stefangrozdanovski-sys/modular_esp32_board/hardware/docs/board_bottom.png

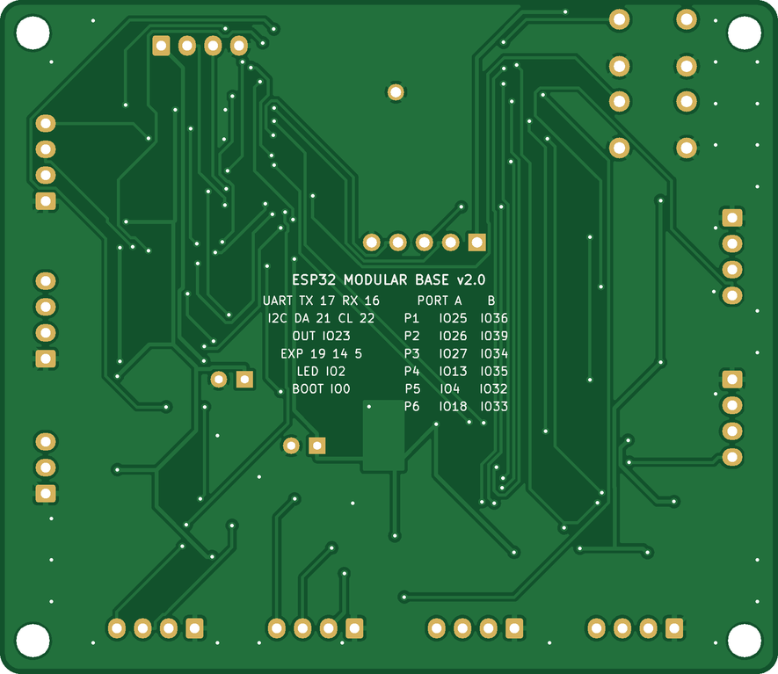
hardware/docs/board_bottom.png
