stefangrozdanovski-sys/modular_esp32_board/production/pcba/esp32-modular-v2.0-BOM-JLCPCB.csv

Comment | Designator | Footprint | LCSC Part #
ESP32-WROOM-32E-N4 | U1 | ESP32-WROOM-32_HandSolder | C701341
AMS1117-3.3 | U2 | SOT-223-3_TabPin2 | C6186
CH340C | U3 | SOIC-16_3.9x9.9mm_P1.27mm | C84681
USBLC6-2SC6 | U4 | SOT-23-6 | C7519
MMBT3904 | Q1,Q2 | SOT-23 | C20526
AO3400A | Q901 | SOT-23 | C20917
SMAJ5.0A | D1 | D_SMA_Handsoldering | C113952
SS34 | D901 | D_SMA_Handsoldering | C8678
PTC 1.1A 1812 | F1 | Fuse_1812_4532Metric_Pad1.30x3.40mm_HandSolder | C163516
PTC 0.5A 1206 | F101,F201,F301,F401,F501,F601,F701,F801 | Fuse_1206_3216Metric_Pad1.42x1.75mm_HandSolder | C883122
22uF 0805 | C3 | C_0805_2012Metric_Pad1.18x1.45mm_HandSolder | C45783
10uF 0805 | C2,C6 | C_0805_2012Metric_Pad1.18x1.45mm_HandSolder | C15850
1uF 0805 | C7 | C_0805_2012Metric_Pad1.18x1.45mm_HandSolder | C28323
100nF 0805 | C5,C8 | C_0805_2012Metric_Pad1.18x1.45mm_HandSolder | C49678
330R 0805 | R101,R201,R301,R401,R501,R601,R701 | R_0805_2012Metric_Pad1.20x1.40mm_HandSolder | C17630
1k 0805 | R10,R11,R104,R204,R304,R404,R504,R604 | R_0805_2012Metric_Pad1.20x1.40mm_HandSolder | C17513
10k 0805 | R1,R2,R3,R4,R704 | R_0805_2012Metric_Pad1.20x1.40mm_HandSolder | C17414
100R 0805 | R801,R804,R901 | R_0805_2012Metric_Pad1.20x1.40mm_HandSolder | C17408
470R 0805 | R5 | R_0805_2012Metric_Pad1.20x1.40mm_HandSolder | C17710
4.7k 0805 | R802,R805 | R_0805_2012Metric_Pad1.20x1.40mm_HandSolder | C17673
22k 0805 | R706 | R_0805_2012Metric_Pad1.20x1.40mm_HandSolder | C17560
100k 0805 | R902 | R_0805_2012Metric_Pad1.20x1.40mm_HandSolder | C149504
LED red 0805 | LED1 | LED_0805_2012Metric_Pad1.15x1.40mm_HandSolder | C84256
LED yellow 0805 | LED2 | LED_0805_2012Metric_Pad1.15x1.40mm_HandSolder | C2296
