stefangrozdanovski-sys/modular_esp32_board/hardware/bom/esp32-modular-v2.0-BOM.xlsx

Sheet: Read me
ESP32 Modular Base v2.0: bill of materials
Schematic and PCB done 2026-10-13 (75 x 65 mm, 2 layers). Generated from the same parts list as the schematic.
 | Build settings
 | Boards to build | 5 | All "Need" quantities scale with this number.
 | How to use this file
 | Yellow cell, blue text |  | You fill this in: In stock, Unit price, Boards to build, option quantities, Fit status.
 | White cell, black text |  | Calculated. Do not type over it.
 | Red-tinted row |  | Something still has to be bought (To buy > 0).
 | Need |  | Qty per board x Boards to build + Spares. Spares cover 0805 parts that fly off the tweezers.
 | To buy |  | Need minus In stock, never below zero.
 | Where to look first |  | My estimate of which parts a local electronics store usually carries. Not a stock check.
 | Qty per board |  | Counted from the Per reference sheet. Change a Fit status there (e.g. DNP to Fit) and the BOM follows.
 | Example row |  | BOM line "XH 3P socket" shows the format: In stock = 100 (the 3P stock you mentioned).
 | Totals
 | Parts per board (placed) | 68
 | BOM lines still to buy | 47
 | Cost of parts to buy (€) | €0.00
 | Note | Cost counts only lines where you entered a unit price.
 | Sheets
 | BOM |  | Every part on the PCB, grouped by value. Stock, to-buy and cost columns.
 | Port options |  | Port map, what each option footprint is for, setup recipes, and option parts to keep in the drawer.
 | Off-board |  | Mating connectors, cables, standoffs, PCB order, crimp tool.
 | Per reference |  | One row per reference designator: value, fitted or empty, footprint. Use it while soldering.

Sheet: BOM
BOM: parts on the PCB
Qty per board and empty footprints are counted from the Per reference sheet. Fill the yellow cells.
# | Block | References | Value | Package | What to look for | Qty / board | Empty footprints | Spares | Need | In stock | To buy | Where to look first | AliExpress search | Substitutes | Typical pack | Unit price (€) | Line cost (€) | Notes
1 | MCU | U1 | ESP-32S (Ai-Thinker) | WROOM-32 footprint, 38 castellated pads | 4 MB flash. WROOM-32 / WROOM-32E fit the same pads | 1 | 0 | 0 | 5 |  | 5 | Have | Ai-Thinker ESP-32S module | ESP32-WROOM-32E (N4), ESP32-WROOM-32D | 1 |  | €0.00 | You already have these: enter the count in "In stock".
2 | 3V3 rail | U2 | AMS1117-3.3 | SOT-223 | 3.3 V fixed LDO, 1 A, tab = output | 1 | 0 | 1 | 6 |  | 6 | Local likely | AMS1117-3.3 SOT-223 | LD1117S33 (same pinout) | 10-50 |  | €0.00 | Not the ADJ version.
3 | USB-UART | U3 | CH340C | SOIC-16 | Must be the C variant: internal oscillator, no crystal | 1 | 0 | 1 | 6 |  | 6 | AliExpress | CH340C SOP-16 | None on this footprint (CH340G needs a crystal) | 10 |  | €0.00 | Marking "CH340C".
4 | USB-UART | U4 | USBLC6-2SC6 | SOT-23-6 | USB ESD protection, 2 lines | 1 | 0 | 1 | 6 |  | 6 | AliExpress | USBLC6-2SC6 SOT-23-6 | USBLC6-2SC6Y | 10-20 |  | €0.00 | If you cannot get it, leave U4 empty: the board works, just without USB ESD protection.
5 | USB-UART | Q1 Q2 | MMBT3904 | SOT-23 | NPN, pin 1 B, 2 E, 3 C (marking 1AM) | 2 | 0 | 1 | 11 |  | 11 | Local maybe | MMBT3904 SOT-23 | MMBT2222A (1P), S8050 SOT-23 (J3Y): same pinout | 50-100 |  | €0.00 | Auto-reset pair.
6 | OUT | Q901 | AO3400A | SOT-23 | N-MOSFET 30 V 5.7 A, logic level (works from 3.3 V gate) | 1 | 0 | 1 | 6 |  | 6 | AliExpress | AO3400A SOT-23 | SI2302 (A2SHB): 20 V max, so 12 V loads only | 50-100 |  | €0.00 | Marking "A09T".
7 | Power in | D1 | SMAJ5.0A | SMA (DO-214AC) | Unidirectional TVS, 5.0 V standoff | 1 | 0 | 1 | 6 |  | 6 | Local maybe | SMAJ5.0A SMA | SMAJ5.0A from any maker. Not the "CA" (bidirectional) | 20-100 |  | €0.00 | Band (cathode) toward +5V.
8 | OUT | D901 | SS34 | SMA (DO-214AC) | Schottky 40 V 3 A | 1 | 0 | 1 | 6 |  | 6 | Local maybe | SS34 SMA DO-214AC | SS24, SS36, SS14 (1 A, fine for small loads) | 50-100 |  | €0.00 | Check the package is SMA, not SMB. Band toward V+.
9 | Power in | F1 | PTC 1.1 A hold | 1812 | Resettable fuse, 1.1 A hold, >= 6 V | 1 | 0 | 1 | 6 |  | 6 | Local maybe | 1812 PTC 1.1A SMD resettable fuse | Bourns MF-MSMF110-2, Littelfuse 1812L110 | 10-50 |  | €0.00 | Marking often "110".
10 | Ports | F101 F201 F301 F401 F501 F601 F701 F801 | PTC 0.5 A hold | 1206 | Resettable fuse, 0.5 A hold, >= 6 V | 8 | 0 | 2 | 42 |  | 42 | AliExpress | 1206 PTC 0.5A SMD resettable fuse | Bourns MF-NSMF050-2, Littelfuse 1206L050 | 50-100 |  | €0.00 | One per port. Fallback: 0R 1206 or a wire bridge (port loses its own protection).
11 | Power | C1 C4 | 100 uF 10 V | Radial 6.3 mm, 2.5 mm pitch | Electrolytic, 10 V or higher, height <= 12 mm | 2 | 0 | 1 | 11 |  | 11 | Local likely | 100uF 16V 6.3x7mm electrolytic | 100 uF 16 V or 25 V in 6.3 mm | 50-100 |  | €0.00 | Mind polarity.
12 | 3V3 rail | C3 | 22 uF | 0805 | X5R, 6.3 V or higher | 1 | 0 | 3 | 8 |  | 8 | Local maybe | 0805 22uF 10V X5R | 10 V rating | 100 |  | €0.00
13 | Power | C2 C6 | 10 uF | 0805 | X5R or X7R, 10 V or higher | 2 | 0 | 5 | 15 |  | 15 | Local maybe | 0805 10uF 10V X5R | 16 V or 25 V rating | 100 |  | €0.00
14 | MCU | C7 | 1 uF | 0805 | X7R, 10 V or higher | 1 | 0 | 3 | 8 |  | 8 | Local likely | 0805 1uF 25V X7R |  | 100 |  | €0.00
15 | Decoupling | C5 C8 | 100 nF | 0805 | X7R, 16 V or higher | 2 | 0 | 5 | 15 |  | 15 | Local likely | 0805 100nF 50V X7R |  | 100 |  | €0.00 | Same value is used as the NTC/analog filter option (Port options sheet).
16 | Resistors | R101 R201 R301 R401 R501 R601 R701 | 330 R | 0805 | 1 % or 5 % | 7 | 0 | 5 | 40 |  | 40 | Local likely | 0805 resistor kit 1% | 220 R to 470 R | 100 / kit |  | €0.00 | Series protection on each port A pin and UART TX.
17 | Resistors | R10 R11 R104 R204 R304 R404 R504 R604 | 1 k | 0805 | 1 % or 5 % | 8 | 0 | 5 | 45 |  | 45 | Local likely | 0805 resistor kit 1% |  | 100 / kit |  | €0.00
18 | Resistors | R1 R2 R3 R4 R704 | 10 k | 0805 | 1 % or 5 % | 5 | 0 | 5 | 30 |  | 30 | Local likely | 0805 resistor kit 1% |  | 100 / kit |  | €0.00
19 | Resistors | R801 R804 R901 | 100 R | 0805 | 1 % or 5 % | 3 | 0 | 3 | 18 |  | 18 | Local likely | 0805 resistor kit 1% | 47 R to 220 R | 100 / kit |  | €0.00
20 | Resistors | R5 | 470 R | 0805 | 1 % or 5 % | 1 | 0 | 3 | 8 |  | 8 | Local likely | 0805 resistor kit 1% | 330 R to 1 k | 100 / kit |  | €0.00
21 | Resistors | R802 R805 | 4.7 k | 0805 | 1 % or 5 % | 2 | 0 | 3 | 13 |  | 13 | Local likely | 0805 resistor kit 1% |  | 100 / kit |  | €0.00 | I2C pull-ups.
22 | Resistors | R706 | 22 k | 0805 | 1 % or 5 % | 1 | 0 | 3 | 8 |  | 8 | Local likely | 0805 resistor kit 1% | 20 k | 100 / kit |  | €0.00 | UART RX 5 V divider bottom.
23 | Resistors | R902 | 100 k | 0805 | 1 % or 5 % | 1 | 0 | 3 | 8 |  | 8 | Local likely | 0805 resistor kit 1% | 47 k | 100 / kit |  | €0.00
24 | Indicators | LED1 | LED red | 0805 | Vf about 2 V | 1 | 0 | 2 | 7 |  | 7 | Local likely | 0805 LED red | Orange | 100 |  | €0.00 | Do not use blue, green or white: Vf too high for 3.3 V with 1 k.
25 | Indicators | LED2 | LED yellow | 0805 | Vf about 2 V | 1 | 0 | 2 | 7 |  | 7 | Local likely | 0805 LED yellow | Orange, red | 100 |  | €0.00 | Cathode mark toward GND.
26 | MCU | SW1 SW2 | Tactile switch | 6 x 6 mm THT, 4 pins | Any height (5 mm typical) | 2 | 0 | 1 | 11 |  | 11 | Local likely | 6x6x5 tactile switch DIP 4 pin |  | 50-100 |  | €0.00 | RESET and BOOT.
27 | Connectors | J1 J101 J201 J301 J401 J501 J601 J701 J801 | XH 4P socket, vertical | JST XH B4B-XH-A, 2.50 mm | Top entry, through-hole. "XH2.54" AliExpress parts fit | 9 | 0 | 1 | 46 |  | 46 | AliExpress | XH2.54 4P straight pin header socket | Plain 1x4 2.54 mm pin header (no lock) | 50-100 |  | €0.00 | 8 ports + USB input. Housings and crimps are on the Off-board sheet.
28 | Connectors | J901 | XH 3P socket, vertical | JST XH B3B-XH-A, 2.50 mm | Top entry, through-hole | 1 | 0 | 1 | 6 | 100 | 0 | Have | XH2.54 3P straight pin header socket | Plain 1x3 2.54 mm pin header | 100 |  | €0.00 | Switched output connector.
29 | Expansion | J902 | 1x5 pin header | 2.54 mm | Optional, only if you use the spare pins | 0 | 1 | 0 | 0 |  | 0 | Local likely | 2.54mm single row male header |  | strip of 40 |  | €0.00 | Footprint only. Fit when needed.
30 | Ports | JP101 JP201 JP301 JP401 JP501 JP601 JP701 JP801 | 3-way solder jumper | PCB copper | No part to buy | 0 | 0 | 0 | 0 |  | 0 | - |  |  |  |  | €0.00 | Set at the factory by a thin trace (1-2 = 3V3; UART port 2-3 = 5V). To change: cut the trace, bridge the other side with solder.
31 | OUT | JP901 | 2-pad solder jumper | PCB copper | No part to buy | 0 | 0 | 0 | 0 |  | 0 | - |  |  |  |  | €0.00 | Open by default. Never bridge it while an external supply is on V+.
32 | Ports | R102 R103 R105 R106 R202 R203 R205 R206 R302 R303 R305 R306 R402 R403 R405 R406 R502 R503 R505 R506 R602 R603 R605 R606 R702 R703 R705 R803 R806 | Option resistors (empty) | 0805 | See Port options sheet | 0 | 29 | 0 | 0 |  | 0 | - |  |  |  |  | €0.00 | Empty by default. Values depend on what you plug in.
33 | Ports | C101 C201 C301 C401 C501 C601 C701 C801 | Option capacitors (empty) | 0805 | See Port options sheet | 0 | 8 | 0 | 0 |  | 0 | - |  |  |  |  | €0.00 | Empty by default. 100 nF for analog, 1 nF for pulses.
34 | Mechanical | H1 H2 H3 H4 | M3 mounting hole | 3.2 mm | Standoffs on Off-board sheet | 0 | 0 | 0 | 0 |  | 0 | - |  |  |  |  | €0.00 | No part on the PCB.
 |  |  |  |  | Totals | 68 | 38 |  |  | Lines to buy | 27 |  |  |  |  | Total | €0.00
 |  |  |  |  | Qty / board counts placed parts per board (solder jumpers and holes are not parts).

Sheet: Port options
Port options
How each port is wired, what the empty footprints are for, and which parts to fit for each job.
1. Port map
Port | Connector | Pin 3: A (GPIO) | Pin 4: B (GPIO) | VP default | Ref numbers | Notes
P1 | J101 | IO25 | IO36 (ADC1) | 3V3 | R101-R106, C101, F101, JP101 | B is input-only, no internal pull-up. Avoid pulse counting on IO36 (false edges with Wi-Fi on).
P2 | J201 | IO26 | IO39 (ADC1) | 3V3 | R201-R206, C201, F201, JP201 | B is input-only, no internal pull-up. Avoid pulse counting on IO39 (false edges with Wi-Fi on).
P3 | J301 | IO27 | IO34 (ADC1) | 3V3 | R301-R306, C301, F301, JP301 | B is input-only, no internal pull-up. Good for 5 V pulse inputs.
P4 | J401 | IO13 | IO35 (ADC1) | 3V3 | R401-R406, C401, F401, JP401 | B is input-only, no internal pull-up. Good for 5 V pulse inputs.
P5 | J501 | IO4 | IO32 (ADC1) | 3V3 | R501-R506, C501, F501, JP501 | B is a full GPIO with ADC1: second UART, second I2C, RS485 direction pin.
P6 | J601 | IO18 | IO33 (ADC1) | 3V3 | R601-R606, C601, F601, JP601 | B is a full GPIO with ADC1: second UART, second I2C, RS485 direction pin.
UART | J701 | IO17 | IO16 | 5V | R701-R706, C701, F701, JP701 | A = TX out, B = RX in through a 10k/22k divider (5 V devices). For a 3.3 V device remove R706.
I2C | J801 | IO21 | IO22 | 3V3 | R801-R806, C801, F801, JP801 | A = SDA, B = SCL, 4.7 k pull-ups to 3V3 fitted. Remove pull-ups on 5 V modules (e.g. LCD backpack).
OUT | J901 | IO23 -> AO3400A gate | - | V+ external | Q901, R901, R902, D901, JP901 | Pins: 1 GND, 2 V+, 3 OUT. Load between V+ and OUT. Up to about 2 A, 24 V. JP901 ties V+ to 5V (open by default).
Fixed | - | IO0 BOOT, IO1/IO3 CH340, IO2 status LED | - | - | J902 (empty): 3V3, IO19, IO14, IO5, GND | IO5 and IO14 pulse at boot: inputs only. IO12 and IO15 unused (boot strapping).
2. Positions in every port (n = port number: 1-6 = P1-P6, 7 = UART, 8 = I2C)
Position | Ref | Default | Role
J | Jn01 | XH 4P | Port connector: 1 GND, 2 VP, 3 A, 4 B
JP | JPn01 | VP select | VP source: 1-2 = 3V3, 2-3 = 5V
F | Fn01 | PTC 0.5A | Per-port PTC on VP
RA | Rn01 | 330R | Series resistor, A <-> GPIO
RAU | Rn02 | empty | Pull-up, A (connector side) -> 3V3
RAD | Rn03 | empty | Pull-down, A (connector side) -> GND
RB | Rn04 | 1k | Series resistor, B <-> GPIO
RBU | Rn05 | empty | Pull-up, B (connector side) -> 3V3
RBD | Rn06 | empty | Pull-down, B (GPIO side) -> GND (divider bottom)
CB | Cn01 | empty | Filter cap, B (GPIO side) -> GND
3. Recipes: what to fit for each job
Job | Port pin | VP jumper | Fit (on top of defaults) | ESPHome | Example (port P3) | Notes
Relay module, low-level trigger | A | 3V3 | Nothing | switch: gpio, inverted: true | Defaults only | Most 3.3 V relay modules. 5V module: VP to 5V only if its IN switches from a 3.3 V high.
Relay module, high-level trigger | A | 3V3 | RAD 10 k | switch: gpio | R303 = 10k | Keeps the relay off during boot.
DS18B20 (1-Wire) | A | 3V3 | RAU 4.7 k | one_wire + dallas_temp | R302 = 4k7 | Several sensors can share one port.
Button or dry contact | A | - | Nothing (internal pull-up); RAU 10 k for long cables | binary_sensor: gpio | R302 = 10k (long cable) | Contact between A and GND.
NTC 10 k (B3950) | B | - | RBU 10 k 1 %, CB 100 nF | adc + resistance + ntc | R305 = 10k 1%, C301 = 100nF | RB 1 k stays fitted. Same circuit as v1.0.
0-3.3 V analog sensor | B | as sensor needs | CB 100 nF | adc (attenuation: 12db) | C301 = 100nF | Signal above 3.3 V: use the 5 V divider row.
5 V logic or pulse (flow sensor with 5 V output) | B (P3-P6) | 5V | RB 10 k (replace 1 k), RBD 22 k, CB 1 nF | pulse_counter | R304 = 10k, R306 = 22k, C301 = 1nF | Check first: sensor powered, output idles at 5 V = this row. Floating = next row.
Open-collector pulse (flow sensor) | A | 5V | RAU 10 k | pulse_counter | R302 = 10k | Pull-up goes to 3V3, so the ESP32 never sees 5 V.
PZEM-004T energy meter | UART port | 5V (default) | Nothing | uart + modbus + pzemac | J701 | Cable: GND-GND, 5V-5V, board TX -> PZEM RX, board RX <- PZEM TX.
RS485 module (Modbus) | UART port + P5 or P6 B | 5V | Remove R706 if the module is 3.3 V | uart + modbus (flow_control_pin) | Direction pin on IO32 (P5 B) | Auto-direction modules need no extra pin.
I2C sensors (BME280, SHT3x, ADS1115, OLED) | I2C port | 3V3 (default) | Nothing | i2c + sensor | J801 | Several modules can share the port with a splitter.
Solid-state relay (DC input), buzzer, 12/24 V LED, fan | OUT | V+ from load supply | Nothing | output: gpio or ledc | J901 | Supply negative to GND pin 1. Load between V+ and OUT.
4. Option parts to keep in the drawer (on top of the BOM quantities)
Value | Package | Used for | Suggested qty | In stock | To buy | AliExpress search
10 k 1 % | 0805 | NTC reference (RBU) | 10 |  | 10 | 0805 resistor 10k 1%
10 k | 0805 | Pull-ups, pull-downs, divider series (RAU, RAD, RB) | 20 |  | 20 | 0805 resistor kit 1%
4.7 k | 0805 | DS18B20 pull-up (RAU) | 10 |  | 10 | 0805 resistor kit 1%
22 k | 0805 | 5 V divider bottom (RBD) | 10 |  | 10 | 0805 resistor kit 1%
100 nF | 0805 | Analog / NTC filter (CB) | 10 |  | 10 | 0805 100nF 50V X7R
1 nF | 0805 | Pulse input filter (CB) | 10 |  | 10 | 0805 1nF 50V C0G
0 R | 0805 | Bypass a series resistor | 10 |  | 10 | 0805 0 ohm resistor
0 R | 1206 | Bypass a port PTC if you have none | 5 |  | 5 | 1206 0 ohm resistor
 |  | Quantities are a drawer stock, not per board; they do not scale with Boards to build.

Sheet: Off-board
Off-board parts
Everything you need that is not soldered to the PCB.
Item | Spec | Qty | Basis | Spares | Need | In stock | To buy | Where to look first | AliExpress search | Unit price (€) | Line cost (€) | Notes
PCB | 2 layers, 75 x 65 mm, 1.6 mm, 1 oz, HASL lead-free | 1 | per board | 0 | 5 |  | 5 | Ordered |  |  | €0.00 | Ordered 2026-10-14 from Seeed Fusion: 5 boards $9.90 + $16.48 shipping.
XH 4P housing (female plug) | JST XH 2.50 mm, 4 positions | 9 | per board | 2 | 47 |  | 47 | AliExpress | XH2.54 4P housing |  | €0.00 | One per port in use (8 ports + USB input). Buy fewer if you won't use every port.
XH crimp terminals | For XH housings, AWG 22-28 | 39 | per board | 20 | 215 |  | 215 | AliExpress | XH2.54 crimp terminal |  | €0.00 | 9 x 4P + 1 x 3P = 39 per fully wired board. Spares for bad crimps.
XH 3P housing (female plug) | JST XH 2.50 mm, 3 positions | 1 | per board | 0 | 5 |  | 5 | Have | XH2.54 3P housing |  | €0.00 | For the OUT connector. Your 3P kit likely covers it.
XH 4P pre-crimped lead (alternative) | 20 cm, one end with housing | 0 | per board | 0 | 0 |  | 0 | AliExpress | XH2.54 4P cable single head 20cm |  | €0.00 | Instead of crimping yourself. Set Qty if you go this way.
USB-C breakout (bare) | Pads V, D-, D+, G; no CC resistors | 1 | per board | 0 | 5 |  | 5 | Have | USB type C breakout board |  | €0.00 | Needs a USB-A to C cable (no CC resistors).
USB-A to USB-C cable | Data-capable, short | 1 | per board | 0 | 5 |  | 5 | Local likely | USB A to type C cable 30cm |  | €0.00 | Data lines are needed for flashing and logs.
USB charger 5 V | 2 A or more, CE marked | 1 | per board | 0 | 5 |  | 5 | Local likely |  |  | €0.00 | Mains side of the box, behind the divider.
Lead wire, J1 to breakout | 4 cores, AWG 24-26, under 10 cm | 1 | per board | 0 | 5 |  | 5 | Local likely |  |  | €0.00 | Twist D+ and D-.
M3 nylon standoff | Male-female, 10 mm | 4 | per board | 0 | 20 |  | 20 | Local maybe | M3 nylon standoff 10mm |  | €0.00
M3 nylon screw | 6 mm | 4 | per board | 0 | 20 |  | 20 | Local maybe | M3 nylon screw 6mm |  | €0.00 | Board side.
M3 nylon nut | M3 | 4 | per board | 0 | 20 |  | 20 | Local maybe | M3 nylon nut |  | €0.00 | Base-plate side, if the box needs it.
Crimp tool for XH | For 2.5 mm JST-style terminals (e.g. IWISS SN-28B / SN-01BM) | 1 | one-off | 0 | 1 |  | 1 | AliExpress | SN-28B crimping tool |  | €0.00 | Skip if you already have one.
 |  |  |  |  |  | Lines to buy | 12 |  |  | Total | €0.00

Sheet: Per reference
Per reference
One row per reference designator. Fit: Fit = solder it, DNP = leave empty, Trace/Open = solder jumper, Hole = no part.
Ref | Block | Value | Fit | Function / connection | KiCad footprint | BOM line # | BOM line
C1 | Power in | 100uF 10V | Fit | +5V bulk | CP_Radial_D6.3mm_P2.50mm | 11 | 100 uF 10 V
C2 | Power in | 10uF | Fit | +5V ceramic | C_0805_2012Metric_Pad1.18x1.45mm_HandSolder | 13 | 10 uF
D1 | Power in | SMAJ5.0A | Fit | TVS on +5V, band to +5V | D_SMA_Handsoldering | 7 | SMAJ5.0A
F1 | Power in | PTC 1.1A | Fit | Input PTC, VBUS_IN -> +5V | Fuse_1812_4532Metric_Pad1.30x3.40mm_HandSolder | 9 | PTC 1.1 A hold
J1 | Power in | XH 4P | Fit | USB-C breakout in: 1 VBUS, 2 D-, 3 D+, 4 GND | JST_XH_B4B-XH-A_1x04_P2.50mm_Vertical | 27 | XH 4P socket, vertical
C3 | 3V3 rail | 22uF | Fit | 3V3 ceramic at LDO output | C_0805_2012Metric_Pad1.18x1.45mm_HandSolder | 12 | 22 uF
C4 | 3V3 rail | 100uF 10V | Fit | 3V3 bulk (Wi-Fi TX, relay coils) | CP_Radial_D6.3mm_P2.50mm | 11 | 100 uF 10 V
U2 | 3V3 rail | AMS1117-3.3 | Fit | 5V -> 3V3 LDO, tab = 3V3 | SOT-223-3_TabPin2 | 2 | AMS1117-3.3
C8 | USB-UART | 100nF | Fit | CH340C decoupling | C_0805_2012Metric_Pad1.18x1.45mm_HandSolder | 15 | 100 nF
Q1 | USB-UART | MMBT3904 | Fit | Auto-reset: DTR -> EN | SOT-23 | 5 | MMBT3904
Q2 | USB-UART | MMBT3904 | Fit | Auto-reset: RTS -> IO0 | SOT-23 | 5 | MMBT3904
R3 | USB-UART | 10k | Fit | Q1 base resistor | R_0805_2012Metric_Pad1.20x1.40mm_HandSolder | 18 | 10 k
R4 | USB-UART | 10k | Fit | Q2 base resistor | R_0805_2012Metric_Pad1.20x1.40mm_HandSolder | 18 | 10 k
R5 | USB-UART | 470R | Fit | CH340 TXD -> ESP RXD0 | R_0805_2012Metric_Pad1.20x1.40mm_HandSolder | 20 | 470 R
U3 | USB-UART | CH340C | Fit | USB-UART, 3.3 V mode (VCC = V3 = 3V3) | SOIC-16_3.9x9.9mm_P1.27mm | 3 | CH340C
U4 | USB-UART | USBLC6-2SC6 | Fit | ESD on D+/D- | SOT-23-6 | 4 | USBLC6-2SC6
C5 | MCU | 100nF | Fit | ESP32 decoupling | C_0805_2012Metric_Pad1.18x1.45mm_HandSolder | 15 | 100 nF
C6 | MCU | 10uF | Fit | ESP32 decoupling | C_0805_2012Metric_Pad1.18x1.45mm_HandSolder | 13 | 10 uF
C7 | MCU | 1uF | Fit | EN delay | C_0805_2012Metric_Pad1.18x1.45mm_HandSolder | 14 | 1 uF
R1 | MCU | 10k | Fit | EN pull-up | R_0805_2012Metric_Pad1.20x1.40mm_HandSolder | 18 | 10 k
R2 | MCU | 10k | Fit | IO0 pull-up | R_0805_2012Metric_Pad1.20x1.40mm_HandSolder | 18 | 10 k
SW1 | MCU | RESET | Fit | EN to GND | SW_PUSH_6mm | 26 | Tactile switch
SW2 | MCU | BOOT | Fit | IO0 to GND (user button after boot) | SW_PUSH_6mm | 26 | Tactile switch
U1 | MCU | ESP-32S | Fit | Ai-Thinker ESP-32S / WROOM-32(E) | ESP32-WROOM-32_HandSolder | 1 | ESP-32S (Ai-Thinker)
LED1 | Indicators | Red | Fit | Power LED | LED_0805_2012Metric_Pad1.15x1.40mm_HandSolder | 24 | LED red
LED2 | Indicators | Yellow | Fit | Status LED (IO2) | LED_0805_2012Metric_Pad1.15x1.40mm_HandSolder | 25 | LED yellow
R10 | Indicators | 1k | Fit | Power LED resistor | R_0805_2012Metric_Pad1.20x1.40mm_HandSolder | 17 | 1 k
R11 | Indicators | 1k | Fit | Status LED resistor (IO2) | R_0805_2012Metric_Pad1.20x1.40mm_HandSolder | 17 | 1 k
C101 | Port P1 | empty | DNP | P1 CB: Filter cap, B (GPIO side) -> GND (IO36) | C_0805_2012Metric_Pad1.18x1.45mm_HandSolder | 33 | Option capacitors (empty)
F101 | Port P1 | PTC 0.5A | Fit | P1 F: Per-port PTC on VP | Fuse_1206_3216Metric_Pad1.42x1.75mm_HandSolder | 10 | PTC 0.5 A hold
J101 | Port P1 | XH 4P | Fit | P1 J: Port connector: 1 GND, 2 VP, 3 A, 4 B | JST_XH_B4B-XH-A_1x04_P2.50mm_Vertical | 27 | XH 4P socket, vertical
JP101 | Port P1 | VP = 3V3 (1-2 bridged) | Trace | P1 JP: VP source: 1-2 = 3V3, 2-3 = 5V | SolderJumper-3_P1.3mm_Bridged12_RoundedPad1.0x1.5mm | 30 | 3-way solder jumper
R101 | Port P1 | 330R | Fit | P1 RA: Series resistor, A <-> GPIO (IO25) | R_0805_2012Metric_Pad1.20x1.40mm_HandSolder | 16 | 330 R
R102 | Port P1 | empty | DNP | P1 RAU: Pull-up, A (connector side) -> 3V3 (IO25) | R_0805_2012Metric_Pad1.20x1.40mm_HandSolder | 32 | Option resistors (empty)
R103 | Port P1 | empty | DNP | P1 RAD: Pull-down, A (connector side) -> GND (IO25) | R_0805_2012Metric_Pad1.20x1.40mm_HandSolder | 32 | Option resistors (empty)
R104 | Port P1 | 1k | Fit | P1 RB: Series resistor, B <-> GPIO (IO36) | R_0805_2012Metric_Pad1.20x1.40mm_HandSolder | 17 | 1 k
R105 | Port P1 | empty | DNP | P1 RBU: Pull-up, B (connector side) -> 3V3 (IO36) | R_0805_2012Metric_Pad1.20x1.40mm_HandSolder | 32 | Option resistors (empty)
R106 | Port P1 | empty | DNP | P1 RBD: Pull-down, B (GPIO side) -> GND (divider bottom) (IO36) | R_0805_2012Metric_Pad1.20x1.40mm_HandSolder | 32 | Option resistors (empty)
C201 | Port P2 | empty | DNP | P2 CB: Filter cap, B (GPIO side) -> GND (IO39) | C_0805_2012Metric_Pad1.18x1.45mm_HandSolder | 33 | Option capacitors (empty)
F201 | Port P2 | PTC 0.5A | Fit | P2 F: Per-port PTC on VP | Fuse_1206_3216Metric_Pad1.42x1.75mm_HandSolder | 10 | PTC 0.5 A hold
J201 | Port P2 | XH 4P | Fit | P2 J: Port connector: 1 GND, 2 VP, 3 A, 4 B | JST_XH_B4B-XH-A_1x04_P2.50mm_Vertical | 27 | XH 4P socket, vertical
JP201 | Port P2 | VP = 3V3 (1-2 bridged) | Trace | P2 JP: VP source: 1-2 = 3V3, 2-3 = 5V | SolderJumper-3_P1.3mm_Bridged12_RoundedPad1.0x1.5mm | 30 | 3-way solder jumper
R201 | Port P2 | 330R | Fit | P2 RA: Series resistor, A <-> GPIO (IO26) | R_0805_2012Metric_Pad1.20x1.40mm_HandSolder | 16 | 330 R
R202 | Port P2 | empty | DNP | P2 RAU: Pull-up, A (connector side) -> 3V3 (IO26) | R_0805_2012Metric_Pad1.20x1.40mm_HandSolder | 32 | Option resistors (empty)
R203 | Port P2 | empty | DNP | P2 RAD: Pull-down, A (connector side) -> GND (IO26) | R_0805_2012Metric_Pad1.20x1.40mm_HandSolder | 32 | Option resistors (empty)
R204 | Port P2 | 1k | Fit | P2 RB: Series resistor, B <-> GPIO (IO39) | R_0805_2012Metric_Pad1.20x1.40mm_HandSolder | 17 | 1 k
R205 | Port P2 | empty | DNP | P2 RBU: Pull-up, B (connector side) -> 3V3 (IO39) | R_0805_2012Metric_Pad1.20x1.40mm_HandSolder | 32 | Option resistors (empty)
R206 | Port P2 | empty | DNP | P2 RBD: Pull-down, B (GPIO side) -> GND (divider bottom) (IO39) | R_0805_2012Metric_Pad1.20x1.40mm_HandSolder | 32 | Option resistors (empty)
C301 | Port P3 | empty | DNP | P3 CB: Filter cap, B (GPIO side) -> GND (IO34) | C_0805_2012Metric_Pad1.18x1.45mm_HandSolder | 33 | Option capacitors (empty)
F301 | Port P3 | PTC 0.5A | Fit | P3 F: Per-port PTC on VP | Fuse_1206_3216Metric_Pad1.42x1.75mm_HandSolder | 10 | PTC 0.5 A hold
J301 | Port P3 | XH 4P | Fit | P3 J: Port connector: 1 GND, 2 VP, 3 A, 4 B | JST_XH_B4B-XH-A_1x04_P2.50mm_Vertical | 27 | XH 4P socket, vertical
JP301 | Port P3 | VP = 3V3 (1-2 bridged) | Trace | P3 JP: VP source: 1-2 = 3V3, 2-3 = 5V | SolderJumper-3_P1.3mm_Bridged12_RoundedPad1.0x1.5mm | 30 | 3-way solder jumper
R301 | Port P3 | 330R | Fit | P3 RA: Series resistor, A <-> GPIO (IO27) | R_0805_2012Metric_Pad1.20x1.40mm_HandSolder | 16 | 330 R
R302 | Port P3 | empty | DNP | P3 RAU: Pull-up, A (connector side) -> 3V3 (IO27) | R_0805_2012Metric_Pad1.20x1.40mm_HandSolder | 32 | Option resistors (empty)
R303 | Port P3 | empty | DNP | P3 RAD: Pull-down, A (connector side) -> GND (IO27) | R_0805_2012Metric_Pad1.20x1.40mm_HandSolder | 32 | Option resistors (empty)
R304 | Port P3 | 1k | Fit | P3 RB: Series resistor, B <-> GPIO (IO34) | R_0805_2012Metric_Pad1.20x1.40mm_HandSolder | 17 | 1 k
R305 | Port P3 | empty | DNP | P3 RBU: Pull-up, B (connector side) -> 3V3 (IO34) | R_0805_2012Metric_Pad1.20x1.40mm_HandSolder | 32 | Option resistors (empty)
R306 | Port P3 | empty | DNP | P3 RBD: Pull-down, B (GPIO side) -> GND (divider bottom) (IO34) | R_0805_2012Metric_Pad1.20x1.40mm_HandSolder | 32 | Option resistors (empty)
C401 | Port P4 | empty | DNP | P4 CB: Filter cap, B (GPIO side) -> GND (IO35) | C_0805_2012Metric_Pad1.18x1.45mm_HandSolder | 33 | Option capacitors (empty)
F401 | Port P4 | PTC 0.5A | Fit | P4 F: Per-port PTC on VP | Fuse_1206_3216Metric_Pad1.42x1.75mm_HandSolder | 10 | PTC 0.5 A hold
J401 | Port P4 | XH 4P | Fit | P4 J: Port connector: 1 GND, 2 VP, 3 A, 4 B | JST_XH_B4B-XH-A_1x04_P2.50mm_Vertical | 27 | XH 4P socket, vertical
JP401 | Port P4 | VP = 3V3 (1-2 bridged) | Trace | P4 JP: VP source: 1-2 = 3V3, 2-3 = 5V | SolderJumper-3_P1.3mm_Bridged12_RoundedPad1.0x1.5mm | 30 | 3-way solder jumper
R401 | Port P4 | 330R | Fit | P4 RA: Series resistor, A <-> GPIO (IO13) | R_0805_2012Metric_Pad1.20x1.40mm_HandSolder | 16 | 330 R
R402 | Port P4 | empty | DNP | P4 RAU: Pull-up, A (connector side) -> 3V3 (IO13) | R_0805_2012Metric_Pad1.20x1.40mm_HandSolder | 32 | Option resistors (empty)
R403 | Port P4 | empty | DNP | P4 RAD: Pull-down, A (connector side) -> GND (IO13) | R_0805_2012Metric_Pad1.20x1.40mm_HandSolder | 32 | Option resistors (empty)
R404 | Port P4 | 1k | Fit | P4 RB: Series resistor, B <-> GPIO (IO35) | R_0805_2012Metric_Pad1.20x1.40mm_HandSolder | 17 | 1 k
R405 | Port P4 | empty | DNP | P4 RBU: Pull-up, B (connector side) -> 3V3 (IO35) | R_0805_2012Metric_Pad1.20x1.40mm_HandSolder | 32 | Option resistors (empty)
R406 | Port P4 | empty | DNP | P4 RBD: Pull-down, B (GPIO side) -> GND (divider bottom) (IO35) | R_0805_2012Metric_Pad1.20x1.40mm_HandSolder | 32 | Option resistors (empty)
C501 | Port P5 | empty | DNP | P5 CB: Filter cap, B (GPIO side) -> GND (IO32) | C_0805_2012Metric_Pad1.18x1.45mm_HandSolder | 33 | Option capacitors (empty)
F501 | Port P5 | PTC 0.5A | Fit | P5 F: Per-port PTC on VP | Fuse_1206_3216Metric_Pad1.42x1.75mm_HandSolder | 10 | PTC 0.5 A hold
J501 | Port P5 | XH 4P | Fit | P5 J: Port connector: 1 GND, 2 VP, 3 A, 4 B | JST_XH_B4B-XH-A_1x04_P2.50mm_Vertical | 27 | XH 4P socket, vertical
JP501 | Port P5 | VP = 3V3 (1-2 bridged) | Trace | P5 JP: VP source: 1-2 = 3V3, 2-3 = 5V | SolderJumper-3_P1.3mm_Bridged12_RoundedPad1.0x1.5mm | 30 | 3-way solder jumper
R501 | Port P5 | 330R | Fit | P5 RA: Series resistor, A <-> GPIO (IO4) | R_0805_2012Metric_Pad1.20x1.40mm_HandSolder | 16 | 330 R
R502 | Port P5 | empty | DNP | P5 RAU: Pull-up, A (connector side) -> 3V3 (IO4) | R_0805_2012Metric_Pad1.20x1.40mm_HandSolder | 32 | Option resistors (empty)
R503 | Port P5 | empty | DNP | P5 RAD: Pull-down, A (connector side) -> GND (IO4) | R_0805_2012Metric_Pad1.20x1.40mm_HandSolder | 32 | Option resistors (empty)
R504 | Port P5 | 1k | Fit | P5 RB: Series resistor, B <-> GPIO (IO32) | R_0805_2012Metric_Pad1.20x1.40mm_HandSolder | 17 | 1 k
R505 | Port P5 | empty | DNP | P5 RBU: Pull-up, B (connector side) -> 3V3 (IO32) | R_0805_2012Metric_Pad1.20x1.40mm_HandSolder | 32 | Option resistors (empty)
R506 | Port P5 | empty | DNP | P5 RBD: Pull-down, B (GPIO side) -> GND (divider bottom) (IO32) | R_0805_2012Metric_Pad1.20x1.40mm_HandSolder | 32 | Option resistors (empty)
C601 | Port P6 | empty | DNP | P6 CB: Filter cap, B (GPIO side) -> GND (IO33) | C_0805_2012Metric_Pad1.18x1.45mm_HandSolder | 33 | Option capacitors (empty)
F601 | Port P6 | PTC 0.5A | Fit | P6 F: Per-port PTC on VP | Fuse_1206_3216Metric_Pad1.42x1.75mm_HandSolder | 10 | PTC 0.5 A hold
J601 | Port P6 | XH 4P | Fit | P6 J: Port connector: 1 GND, 2 VP, 3 A, 4 B | JST_XH_B4B-XH-A_1x04_P2.50mm_Vertical | 27 | XH 4P socket, vertical
JP601 | Port P6 | VP = 3V3 (1-2 bridged) | Trace | P6 JP: VP source: 1-2 = 3V3, 2-3 = 5V | SolderJumper-3_P1.3mm_Bridged12_RoundedPad1.0x1.5mm | 30 | 3-way solder jumper
R601 | Port P6 | 330R | Fit | P6 RA: Series resistor, A <-> GPIO (IO18) | R_0805_2012Metric_Pad1.20x1.40mm_HandSolder | 16 | 330 R
R602 | Port P6 | empty | DNP | P6 RAU: Pull-up, A (connector side) -> 3V3 (IO18) | R_0805_2012Metric_Pad1.20x1.40mm_HandSolder | 32 | Option resistors (empty)
R603 | Port P6 | empty | DNP | P6 RAD: Pull-down, A (connector side) -> GND (IO18) | R_0805_2012Metric_Pad1.20x1.40mm_HandSolder | 32 | Option resistors (empty)
R604 | Port P6 | 1k | Fit | P6 RB: Series resistor, B <-> GPIO (IO33) | R_0805_2012Metric_Pad1.20x1.40mm_HandSolder | 17 | 1 k
R605 | Port P6 | empty | DNP | P6 RBU: Pull-up, B (connector side) -> 3V3 (IO33) | R_0805_2012Metric_Pad1.20x1.40mm_HandSolder | 32 | Option resistors (empty)
R606 | Port P6 | empty | DNP | P6 RBD: Pull-down, B (GPIO side) -> GND (divider bottom) (IO33) | R_0805_2012Metric_Pad1.20x1.40mm_HandSolder | 32 | Option resistors (empty)
C701 | Port UART | empty | DNP | UART CB: Filter cap, B (GPIO side) -> GND (IO16) | C_0805_2012Metric_Pad1.18x1.45mm_HandSolder | 33 | Option capacitors (empty)
F701 | Port UART | PTC 0.5A | Fit | UART F: Per-port PTC on VP | Fuse_1206_3216Metric_Pad1.42x1.75mm_HandSolder | 10 | PTC 0.5 A hold
J701 | Port UART | XH 4P | Fit | UART J: Port connector: 1 GND, 2 VP, 3 A, 4 B | JST_XH_B4B-XH-A_1x04_P2.50mm_Vertical | 27 | XH 4P socket, vertical
JP701 | Port UART | VP = 5V (2-3 bridged) | Trace | UART JP: VP source: 1-2 = 3V3, 2-3 = 5V | SolderJumper-3_P1.3mm_Bridged12_RoundedPad1.0x1.5mm | 30 | 3-way solder jumper
R701 | Port UART | 330R | Fit | UART RA: Series resistor, A <-> GPIO (IO17) | R_0805_2012Metric_Pad1.20x1.40mm_HandSolder | 16 | 330 R
R702 | Port UART | empty | DNP | UART RAU: Pull-up, A (connector side) -> 3V3 (IO17) | R_0805_2012Metric_Pad1.20x1.40mm_HandSolder | 32 | Option resistors (empty)
R703 | Port UART | empty | DNP | UART RAD: Pull-down, A (connector side) -> GND (IO17) | R_0805_2012Metric_Pad1.20x1.40mm_HandSolder | 32 | Option resistors (empty)
R704 | Port UART | 10k | Fit | UART RB: Series resistor, B <-> GPIO (IO16) | R_0805_2012Metric_Pad1.20x1.40mm_HandSolder | 18 | 10 k
R705 | Port UART | empty | DNP | UART RBU: Pull-up, B (connector side) -> 3V3 (IO16) | R_0805_2012Metric_Pad1.20x1.40mm_HandSolder | 32 | Option resistors (empty)
R706 | Port UART | 22k | Fit | UART RBD: Pull-down, B (GPIO side) -> GND (divider bottom) (IO16) | R_0805_2012Metric_Pad1.20x1.40mm_HandSolder | 22 | 22 k
C801 | Port I2C | empty | DNP | I2C CB: Filter cap, B (GPIO side) -> GND (IO22) | C_0805_2012Metric_Pad1.18x1.45mm_HandSolder | 33 | Option capacitors (empty)
F801 | Port I2C | PTC 0.5A | Fit | I2C F: Per-port PTC on VP | Fuse_1206_3216Metric_Pad1.42x1.75mm_HandSolder | 10 | PTC 0.5 A hold
J801 | Port I2C | XH 4P | Fit | I2C J: Port connector: 1 GND, 2 VP, 3 A, 4 B | JST_XH_B4B-XH-A_1x04_P2.50mm_Vertical | 27 | XH 4P socket, vertical
JP801 | Port I2C | VP = 3V3 (1-2 bridged) | Trace | I2C JP: VP source: 1-2 = 3V3, 2-3 = 5V | SolderJumper-3_P1.3mm_Bridged12_RoundedPad1.0x1.5mm | 30 | 3-way solder jumper
R801 | Port I2C | 100R | Fit | I2C RA: Series resistor, A <-> GPIO (IO21) | R_0805_2012Metric_Pad1.20x1.40mm_HandSolder | 19 | 100 R
R802 | Port I2C | 4k7 | Fit | I2C RAU: Pull-up, A (connector side) -> 3V3 (IO21) | R_0805_2012Metric_Pad1.20x1.40mm_HandSolder | 21 | 4.7 k
R803 | Port I2C | empty | DNP | I2C RAD: Pull-down, A (connector side) -> GND (IO21) | R_0805_2012Metric_Pad1.20x1.40mm_HandSolder | 32 | Option resistors (empty)
R804 | Port I2C | 100R | Fit | I2C RB: Series resistor, B <-> GPIO (IO22) | R_0805_2012Metric_Pad1.20x1.40mm_HandSolder | 19 | 100 R
R805 | Port I2C | 4k7 | Fit | I2C RBU: Pull-up, B (connector side) -> 3V3 (IO22) | R_0805_2012Metric_Pad1.20x1.40mm_HandSolder | 21 | 4.7 k
R806 | Port I2C | empty | DNP | I2C RBD: Pull-down, B (GPIO side) -> GND (divider bottom) (IO22) | R_0805_2012Metric_Pad1.20x1.40mm_HandSolder | 32 | Option resistors (empty)
D901 | OUT | SS34 | Fit | Flyback, OUT (anode) -> V+ (cathode) | D_SMA_Handsoldering | 8 | SS34
J901 | OUT | XH 3P | Fit | Switched output: 1 GND, 2 V+, 3 OUT | JST_XH_B3B-XH-A_1x03_P2.50mm_Vertical | 28 | XH 3P socket, vertical
JP901 | OUT | V+ = 5V link | Open | Bridge only for 5 V loads with no external supply | SolderJumper-2_P1.3mm_Open_RoundedPad1.0x1.5mm | 31 | 2-pad solder jumper
Q901 | OUT | AO3400A | Fit | Low-side N-MOSFET, gate from IO23 | SOT-23 | 6 | AO3400A
R901 | OUT | 100R | Fit | Gate resistor | R_0805_2012Metric_Pad1.20x1.40mm_HandSolder | 19 | 100 R
R902 | OUT | 100k | Fit | Gate pull-down (off at boot) | R_0805_2012Metric_Pad1.20x1.40mm_HandSolder | 23 | 100 k
J902 | Expansion | 1x5 header | DNP | Spare pins: 3V3, IO19, IO14, IO5, GND | PinHeader_1x05_P2.54mm_Vertical | 29 | 1x5 pin header
H1 | Mechanical | M3 | Hole | Mounting hole | MountingHole_3.2mm_M3 | 34 | M3 mounting hole
H2 | Mechanical | M3 | Hole | Mounting hole | MountingHole_3.2mm_M3 | 34 | M3 mounting hole
H3 | Mechanical | M3 | Hole | Mounting hole | MountingHole_3.2mm_M3 | 34 | M3 mounting hole
H4 | Mechanical | M3 | Hole | Mounting hole | MountingHole_3.2mm_M3 | 34 | M3 mounting hole
