stefangrozdanovski-sys/modular_esp32_board/hardware/docs/schematic.pdf

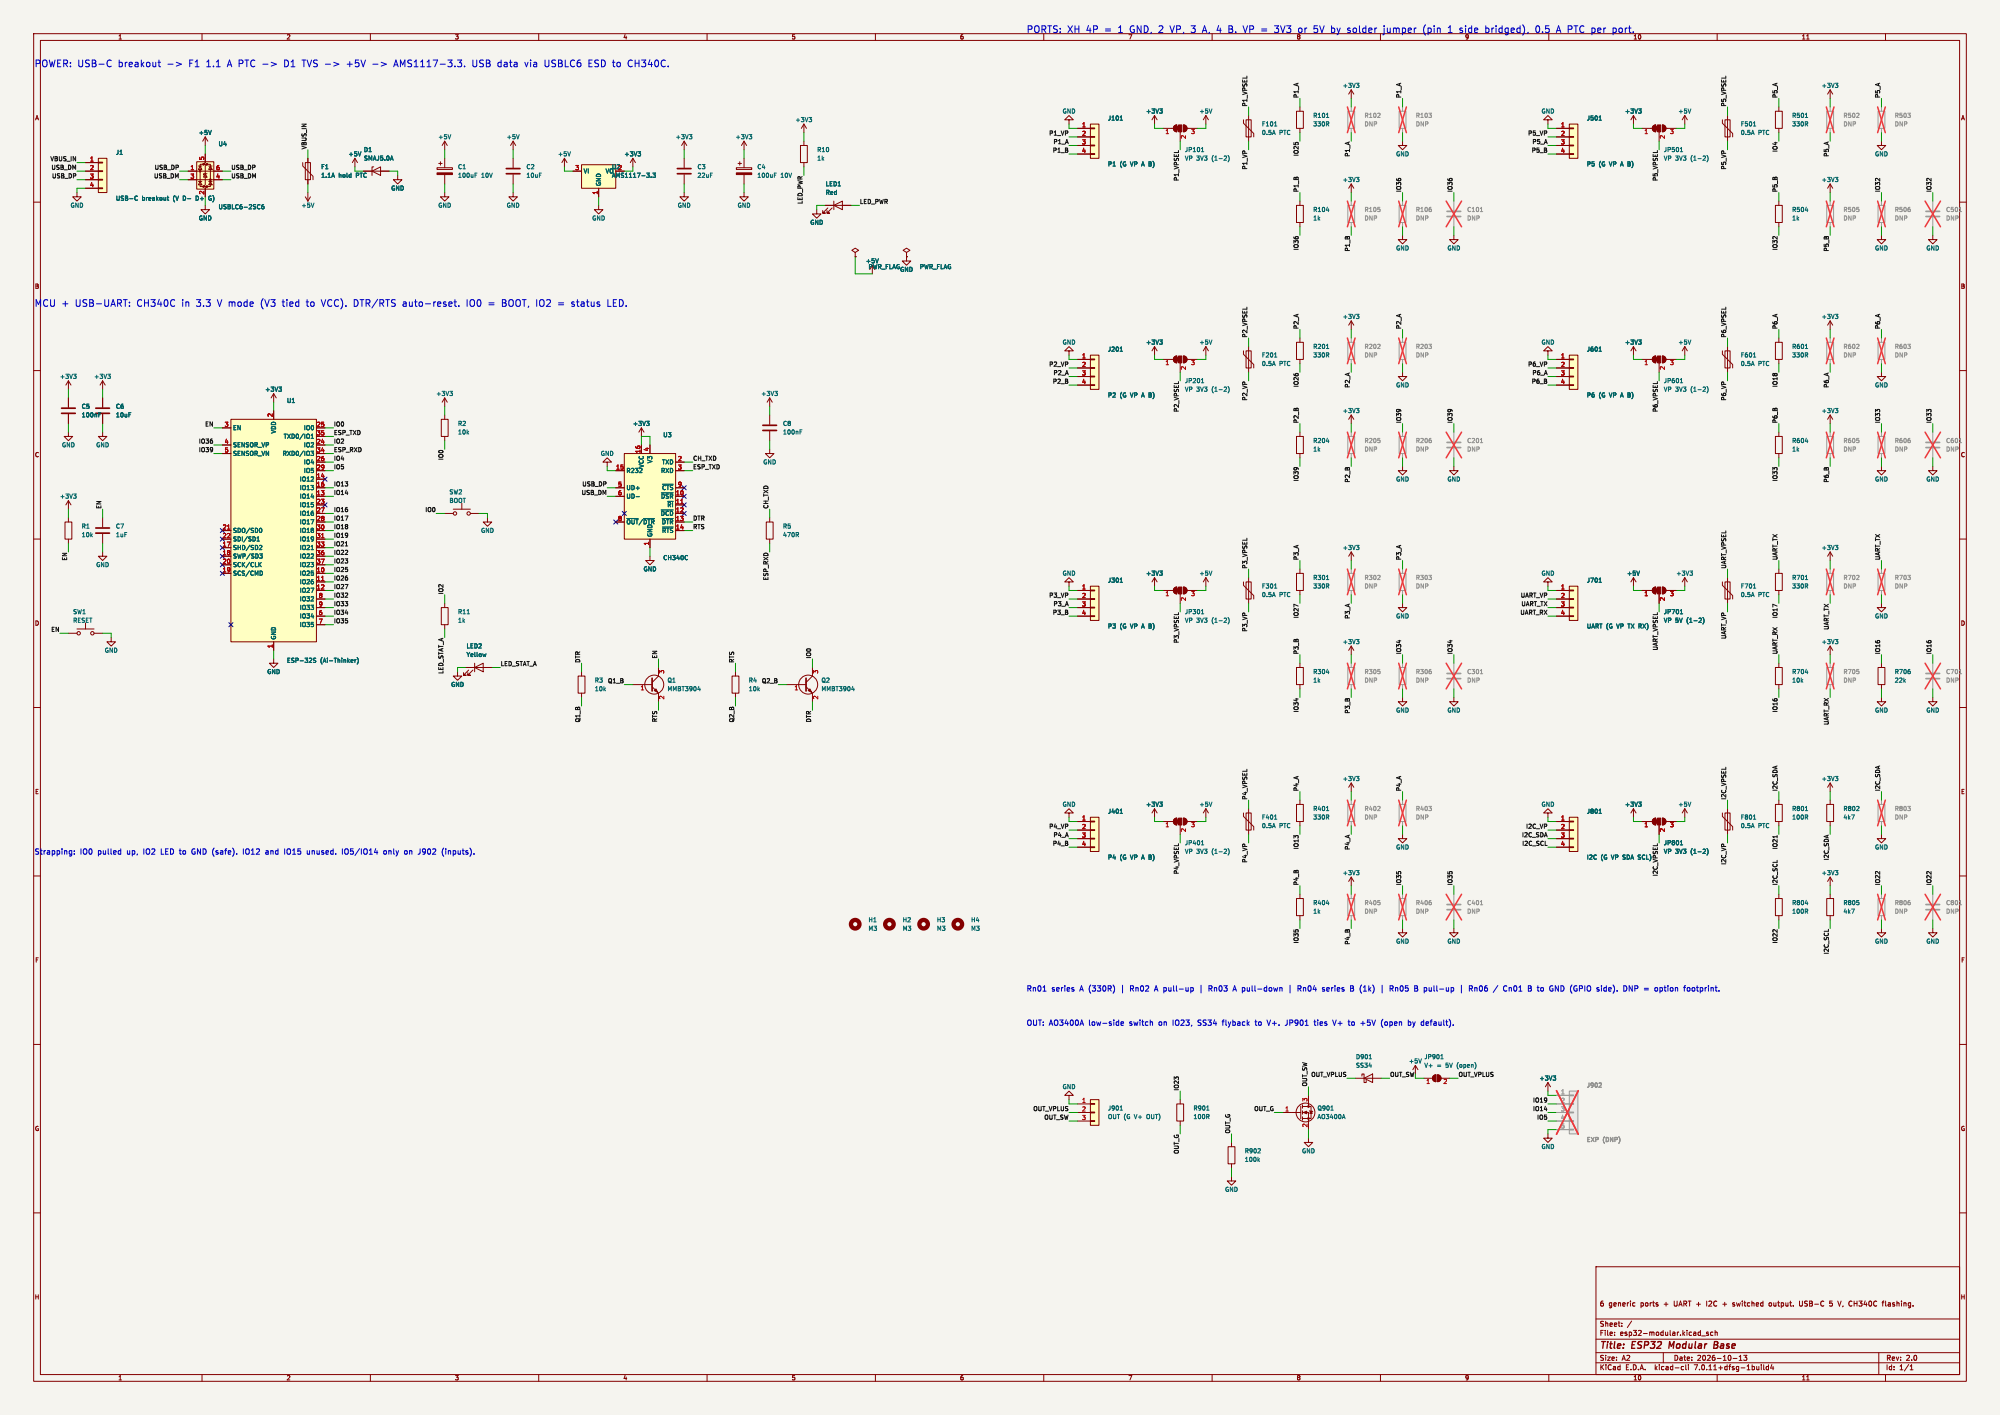
[picture p14: page 1]

4 UD+ 5 UD- 6 ~{OUT}/~{DTR} 8 ~{CTS}9 +3V3GND
100nF GND

4 UD+ 5 UD- 6 ~{OUT}/~{DTR} 8 ~{CTS}9 U3 CH340C

1 ~{DSR} 10 ~{RI} 11 ~{DCD} 12 ~{DTR} 13 ~{RTS} 14 R232 15 VCC 16 TXD 2 RXD 3 V3
