stefangrozdanovski-sys/modular_esp32_board/hardware/esp32-modular.kicad_pcb

## KiCad design hardware/esp32-modular.kicad_pcb (2026-11-05)

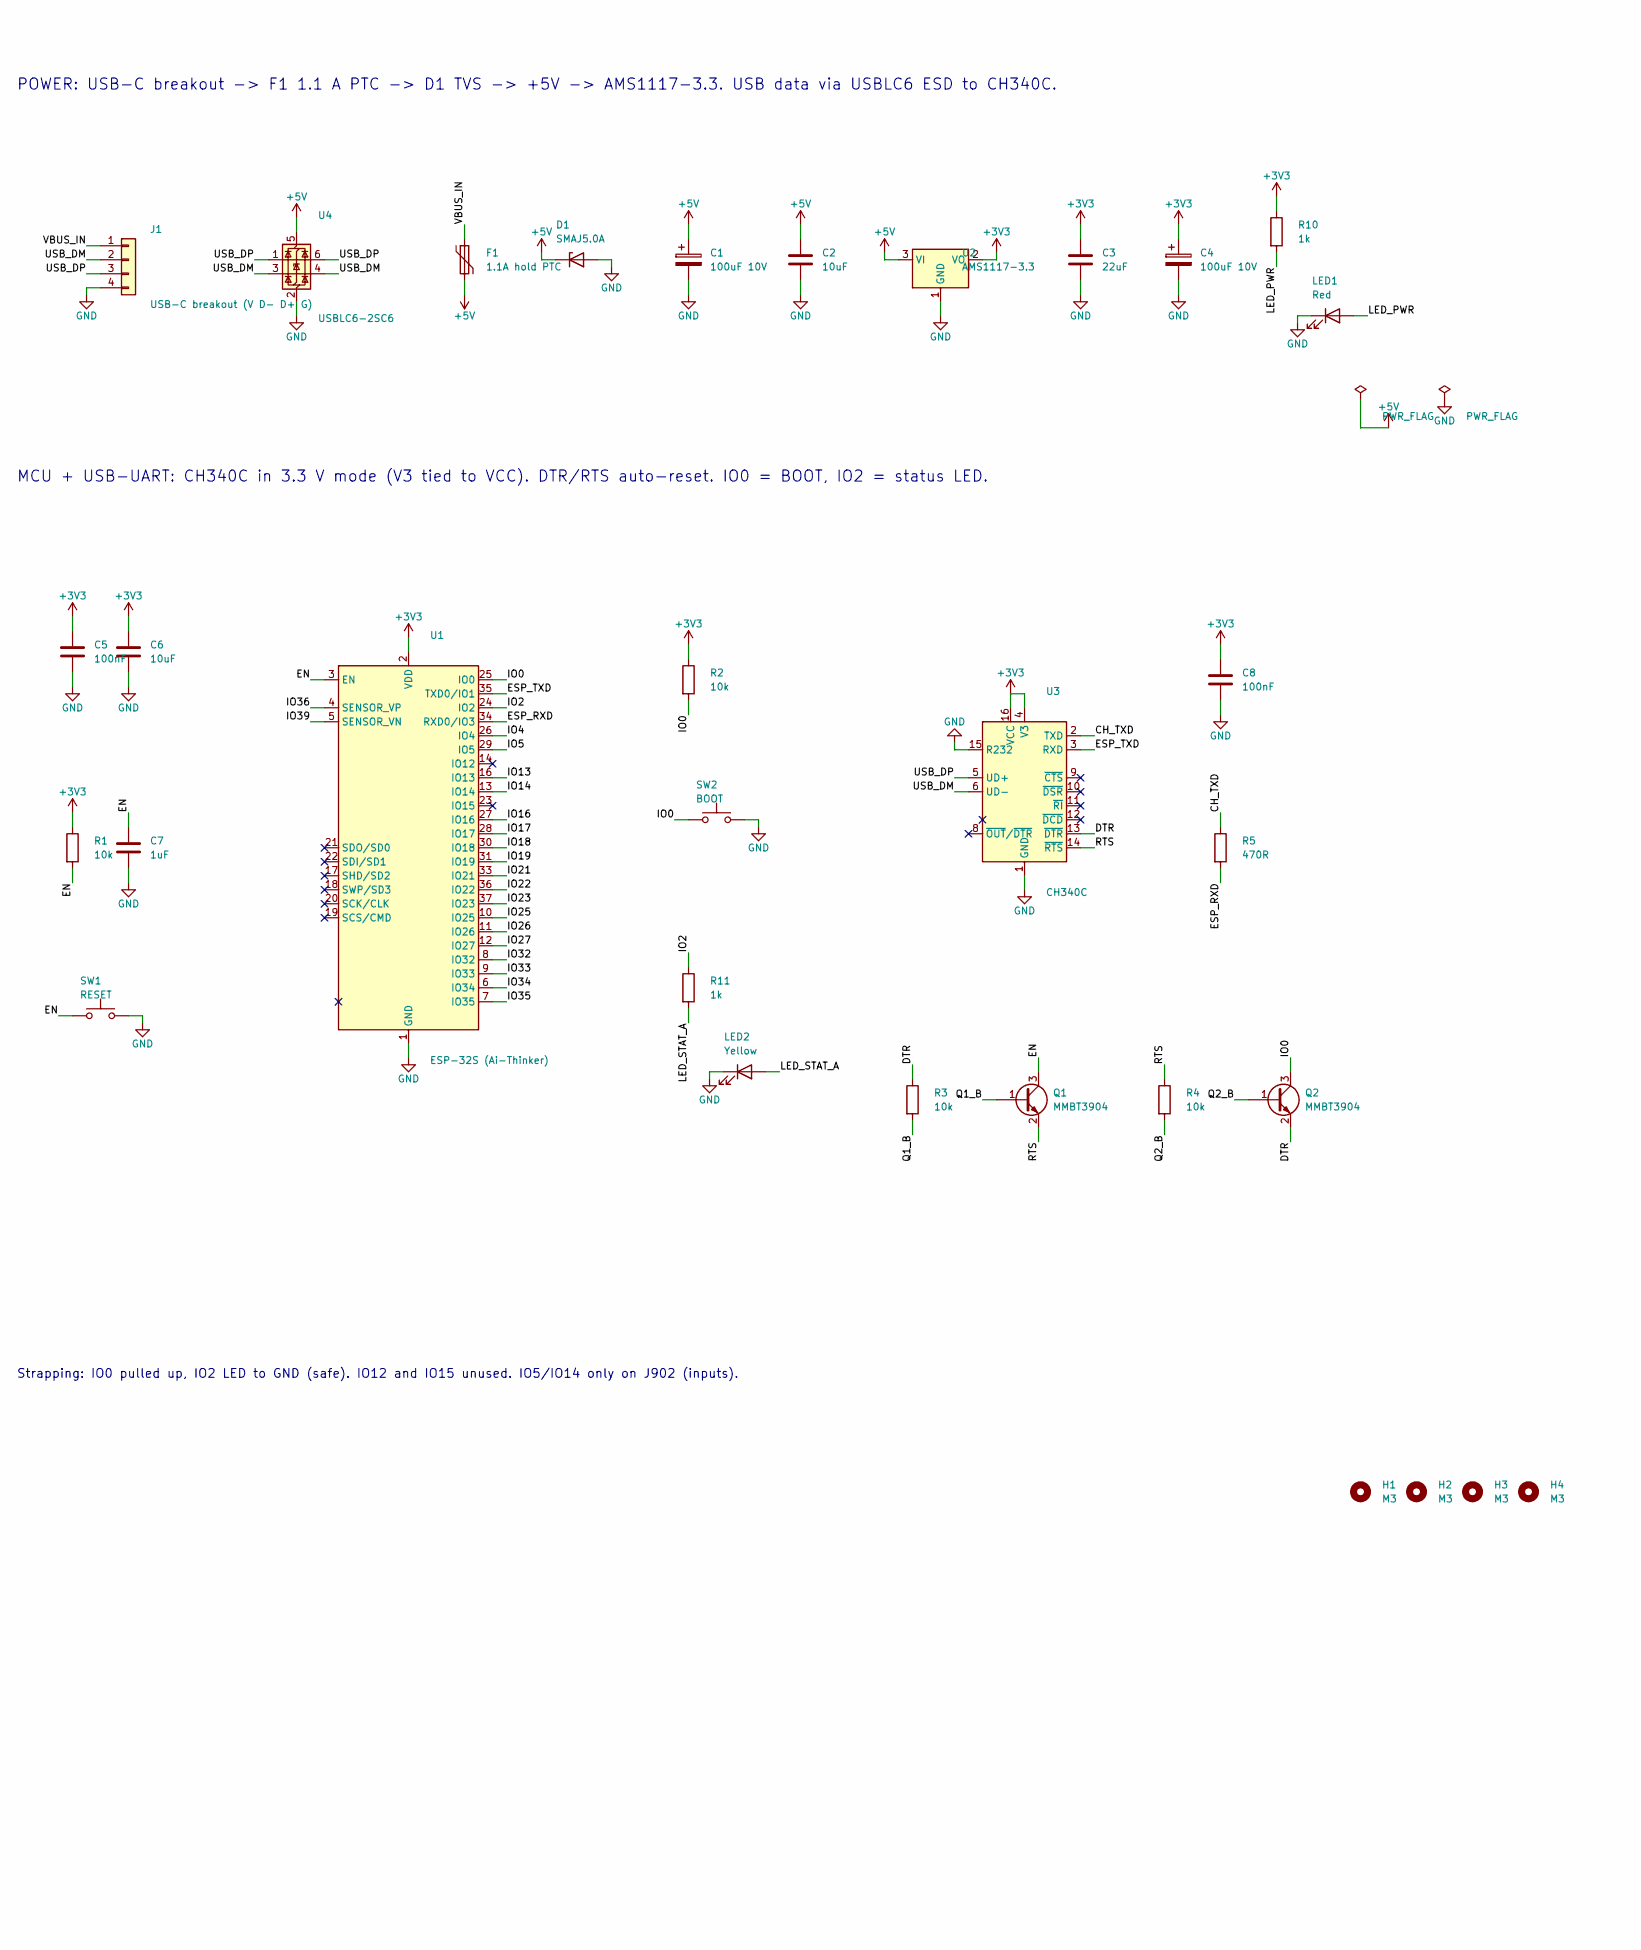
[picture p15: schematic esp32-modular.kicad_sch, ESP32 Modular Base, part in row 1, column 1]

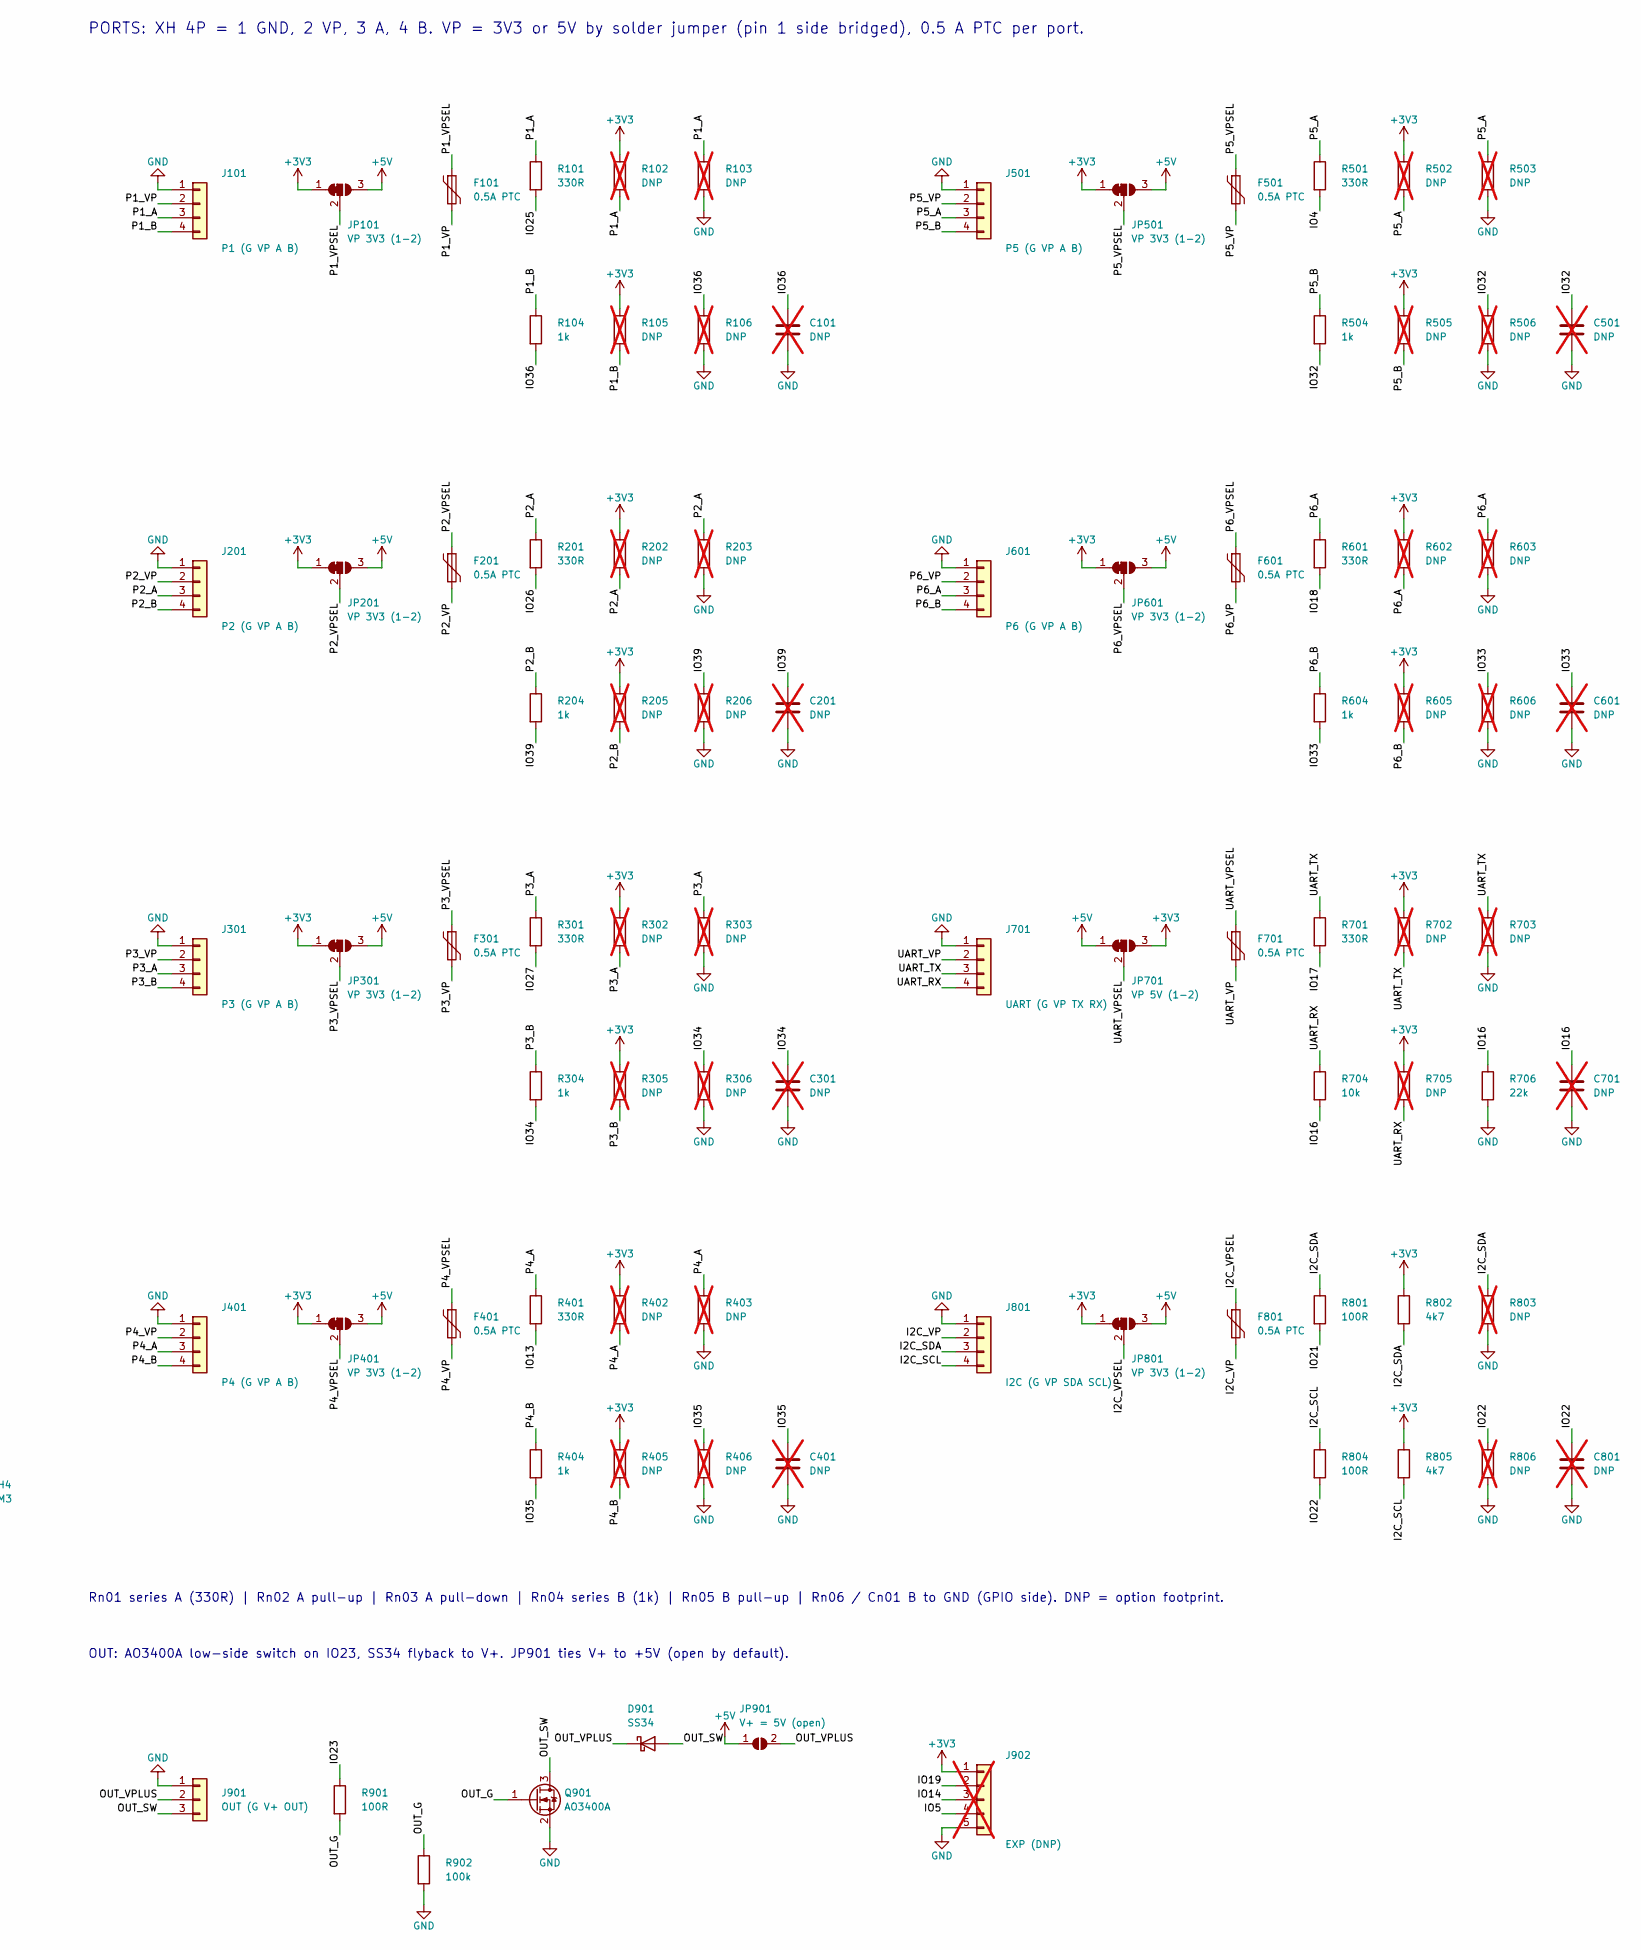
[picture p16: schematic esp32-modular.kicad_sch, ESP32 Modular Base, part in row 1, column 2]

Parts:
C1, C4: 100uF 10V; CP_Radial_D6.3mm_P2.50mm
C2, C6: 10uF; C_0805_2012Metric_Pad1.18x1.45mm_HandSolder
C3: 22uF; C_0805_2012Metric_Pad1.18x1.45mm_HandSolder
C5, C8: 100nF; C_0805_2012Metric_Pad1.18x1.45mm_HandSolder
C7: 1uF; C_0805_2012Metric_Pad1.18x1.45mm_HandSolder
C101, C201, C301, C401, C501, C601, C701, C801: DNP; C_0805_2012Metric_Pad1.18x1.45mm_HandSolder; not fitted
D1: SMAJ5.0A; D_SMA_Handsoldering
D901: SS34; D_SMA_Handsoldering
F1: 1.1A hold PTC; Fuse_1812_4532Metric_Pad1.30x3.40mm_HandSolder
F101, F201, F301, F401, F501, F601, F701, F801: 0.5A PTC; Fuse_1206_3216Metric_Pad1.42x1.75mm_HandSolder
H1, H2, H3, H4: M3; MountingHole_3.2mm_M3
J1: USB-C breakout (V D- D+ G); JST_XH_B4B-XH-A_1x04_P2.50mm_Vertical
J101: P1 (G VP A B); JST_XH_B4B-XH-A_1x04_P2.50mm_Vertical
J201: P2 (G VP A B); JST_XH_B4B-XH-A_1x04_P2.50mm_Vertical
J301: P3 (G VP A B); JST_XH_B4B-XH-A_1x04_P2.50mm_Vertical
J401: P4 (G VP A B); JST_XH_B4B-XH-A_1x04_P2.50mm_Vertical
J501: P5 (G VP A B); JST_XH_B4B-XH-A_1x04_P2.50mm_Vertical
J601: P6 (G VP A B); JST_XH_B4B-XH-A_1x04_P2.50mm_Vertical
J701: UART (G VP TX RX); JST_XH_B4B-XH-A_1x04_P2.50mm_Vertical
J801: I2C (G VP SDA SCL); JST_XH_B4B-XH-A_1x04_P2.50mm_Vertical
J901: OUT (G V+ OUT); JST_XH_B3B-XH-A_1x03_P2.50mm_Vertical
J902: EXP (DNP); PinHeader_1x05_P2.54mm_Vertical; not fitted
JP101, JP201, JP301, JP401, JP501, JP601, JP801: VP 3V3 (1-2); SolderJumper-3_P1.3mm_Bridged12_RoundedPad1.0x1.5mm
JP701: VP 5V (1-2); SolderJumper-3_P1.3mm_Bridged12_RoundedPad1.0x1.5mm
JP901: V+ = 5V (open); SolderJumper-2_P1.3mm_Open_RoundedPad1.0x1.5mm
LED1: Red; LED_0805_2012Metric_Pad1.15x1.40mm_HandSolder
LED2: Yellow; LED_0805_2012Metric_Pad1.15x1.40mm_HandSolder
Q1, Q2: MMBT3904; SOT-23
Q901: AO3400A; SOT-23
R1, R2, R3, R4, R704: 10k; R_0805_2012Metric_Pad1.20x1.40mm_HandSolder
R5: 470R; R_0805_2012Metric_Pad1.20x1.40mm_HandSolder
R10, R11, R104, R204, R304, R404, R504, R604: 1k; R_0805_2012Metric_Pad1.20x1.40mm_HandSolder
R101, R201, R301, R401, R501, R601, R701: 330R; R_0805_2012Metric_Pad1.20x1.40mm_HandSolder
R102, R103, R105, R106, R202, R203, R205, R206, R302, R303, R305, R306, R402, R403, R405, R406, R502, R503, R505, R506, R602, R603, R605, R606, R702, R703, R705, R803, R806: DNP; R_0805_2012Metric_Pad1.20x1.40mm_HandSolder; not fitted
R706: 22k; R_0805_2012Metric_Pad1.20x1.40mm_HandSolder
R801, R804, R901: 100R; R_0805_2012Metric_Pad1.20x1.40mm_HandSolder
R802, R805: 4k7; R_0805_2012Metric_Pad1.20x1.40mm_HandSolder
R902: 100k; R_0805_2012Metric_Pad1.20x1.40mm_HandSolder
SW1: RESET; SW_PUSH_6mm
SW2: BOOT; SW_PUSH_6mm
U1: ESP-32S (Ai-Thinker); ESP32-WROOM-32_HandSolder
U2: AMS1117-3.3; SOT-223-3_TabPin2
U3: CH340C; SOIC-16_3.9x9.9mm_P1.27mm
U4: USBLC6-2SC6; SOT-23-6

Connections:
+3V3: C3.1, C4.1, C5.1, C6.1, C8.1, J902.1, JP101.1 (A), JP201.1 (A), JP301.1 (A), JP401.1 (A), JP501.1 (A), JP601.1 (A), JP701.3 (B), JP801.1 (A), R1.1, R2.1, R10.1, R102.1, R105.1, R202.1, R205.1, R302.1, R305.1, R402.1, R405.1, R502.1, R505.1, R602.1, R605.1, R702.1, R705.1, R802.1, R805.1, U1.2 (VDD), U2.2 (VO), U3.4 (V3), U3.16 (VCC)
+5V: C1.1, C2.1, D1.1 (K), F1.2, JP101.3 (B), JP201.3 (B), JP301.3 (B), JP401.3 (B), JP501.3 (B), JP601.3 (B), JP701.1 (A), JP801.3 (B), JP901.1 (A), U2.3 (VI), U4.5 (VBUS)
/CH_TXD: R5.1, U3.2 (TXD)
/DTR: Q2.2 (E), R3.1, U3.13 (~DTR)
/EN: C7.1, Q1.3 (C), R1.2, SW1.1, U1.3 (EN)
/ESP_RXD: R5.2, U1.34 (RXD0/IO3)
/ESP_TXD: U1.35 (TXD0/IO1), U3.3 (RXD)
/I2C_SCL: J801.4, R804.1, R805.2
/I2C_SDA: J801.3, R801.1, R802.2, R803.1
/I2C_VP: F801.2, J801.2
/I2C_VPSEL: F801.1, JP801.2 (C)
/IO0: Q2.3 (C), R2.2, SW2.1, U1.25 (IO0)
/IO2: R11.1, U1.24 (IO2)
/IO4: R501.2, U1.26 (IO4)
/IO5: J902.4, U1.29 (IO5)
/IO13: R401.2, U1.16 (IO13)
/IO14: J902.3, U1.13 (IO14)
/IO16: C701.1, R704.2, R706.1, U1.27 (IO16)
/IO17: R701.2, U1.28 (IO17)
/IO18: R601.2, U1.30 (IO18)
/IO19: J902.2, U1.31 (IO19)
/IO21: R801.2, U1.33 (IO21)
/IO22: C801.1, R804.2, R806.1, U1.36 (IO22)
/IO23: R901.1, U1.37 (IO23)
/IO25: R101.2, U1.10 (IO25)
/IO26: R201.2, U1.11 (IO26)
/IO27: R301.2, U1.12 (IO27)
/IO32: C501.1, R504.2, R506.1, U1.8 (IO32)
/IO33: C601.1, R604.2, R606.1, U1.9 (IO33)
/IO34: C301.1, R304.2, R306.1, U1.6 (IO34)
/IO35: C401.1, R404.2, R406.1, U1.7 (IO35)
/IO36: C101.1, R104.2, R106.1, U1.4 (SENSOR_VP)
/IO39: C201.1, R204.2, R206.1, U1.5 (SENSOR_VN)
/LED_PWR: LED1.2 (A), R10.2
/LED_STAT_A: LED2.2 (A), R11.2
/OUT_G: Q901.1 (G), R901.2, R902.1
/OUT_SW: D901.2 (A), J901.3, Q901.3 (D)
/OUT_VPLUS: D901.1 (K), J901.2, JP901.2 (B)
/P1_A: J101.3, R101.1, R102.2, R103.1
/P1_B: J101.4, R104.1, R105.2
/P1_VP: F101.2, J101.2
/P1_VPSEL: F101.1, JP101.2 (C)
/P2_A: J201.3, R201.1, R202.2, R203.1
/P2_B: J201.4, R204.1, R205.2
/P2_VP: F201.2, J201.2
/P2_VPSEL: F201.1, JP201.2 (C)
/P3_A: J301.3, R301.1, R302.2, R303.1
/P3_B: J301.4, R304.1, R305.2
/P3_VP: F301.2, J301.2
/P3_VPSEL: F301.1, JP301.2 (C)
/P4_A: J401.3, R401.1, R402.2, R403.1
/P4_B: J401.4, R404.1, R405.2
/P4_VP: F401.2, J401.2
/P4_VPSEL: F401.1, JP401.2 (C)
/P5_A: J501.3, R501.1, R502.2, R503.1
/P5_B: J501.4, R504.1, R505.2
/P5_VP: F501.2, J501.2
/P5_VPSEL: F501.1, JP501.2 (C)
/P6_A: J601.3, R601.1, R602.2, R603.1
/P6_B: J601.4, R604.1, R605.2
/P6_VP: F601.2, J601.2
/P6_VPSEL: F601.1, JP601.2 (C)
/Q1_B: Q1.1 (B), R3.2
/Q2_B: Q2.1 (B), R4.2
/RTS: Q1.2 (E), R4.1, U3.14 (~RTS)
/UART_RX: J701.4, R704.1, R705.2
/UART_TX: J701.3, R701.1, R702.2, R703.1
/UART_VP: F701.2, J701.2
/UART_VPSEL: F701.1, JP701.2 (C)
/USB_DM: J1.2, U3.6 (UD-), U4.3 (I/O2), U4.4 (I/O2)
/USB_DP: J1.3, U3.5 (UD+), U4.1 (I/O1), U4.6 (I/O1)
/VBUS_IN: F1.1, J1.1
GND: C1.2, C2.2, C3.2, C4.2, C5.2, C6.2, C7.2, C8.2, C101.2, C201.2, C301.2, C401.2, C501.2, C601.2, C701.2, C801.2, D1.2 (A), J1.4, J101.1, J201.1, J301.1, J401.1, J501.1, J601.1, J701.1, J801.1, J901.1, J902.5, LED1.1 (K), LED2.1 (K), Q901.2 (S), R103.2, R106.2, R203.2, R206.2, R303.2, R306.2, R403.2, R406.2, R503.2, R506.2, R603.2, R606.2, R703.2, R706.2, R803.2, R806.2, R902.2, SW1.2, SW2.2, U1.1 (GND), U1.15 (GND), U1.38 (GND), U1.39 (GND), U2.1 (GND), U3.1 (GND), U3.15 (R232), U4.2 (GND)

Notes on the sheet:
POWER: USB-C breakout -> F1 1.1 A PTC -> D1 TVS -> +5V -> AMS1117-3.3. USB data via USBLC6 ESD to CH340C.
MCU + USB-UART: CH340C in 3.3 V mode (V3 tied to VCC). DTR/RTS auto-reset. IO0 = BOOT, IO2 = status LED.
Strapping: IO0 pulled up, IO2 LED to GND (safe). IO12 and IO15 unused. IO5/IO14 only on J902 (inputs).
PORTS: XH 4P = 1 GND, 2 VP, 3 A, 4 B. VP = 3V3 or 5V by solder jumper (pin 1 side bridged), 0.5 A PTC per port.
Rn01 series A (330R) | Rn02 A pull-up | Rn03 A pull-down | Rn04 series B (1k) | Rn05 B pull-up | Rn06 / Cn01 B to GND (GPIO side). DNP = option footprint.
OUT: AO3400A low-side switch on IO23, SS34 flyback to V+. JP901 ties V+ to +5V (open by default).

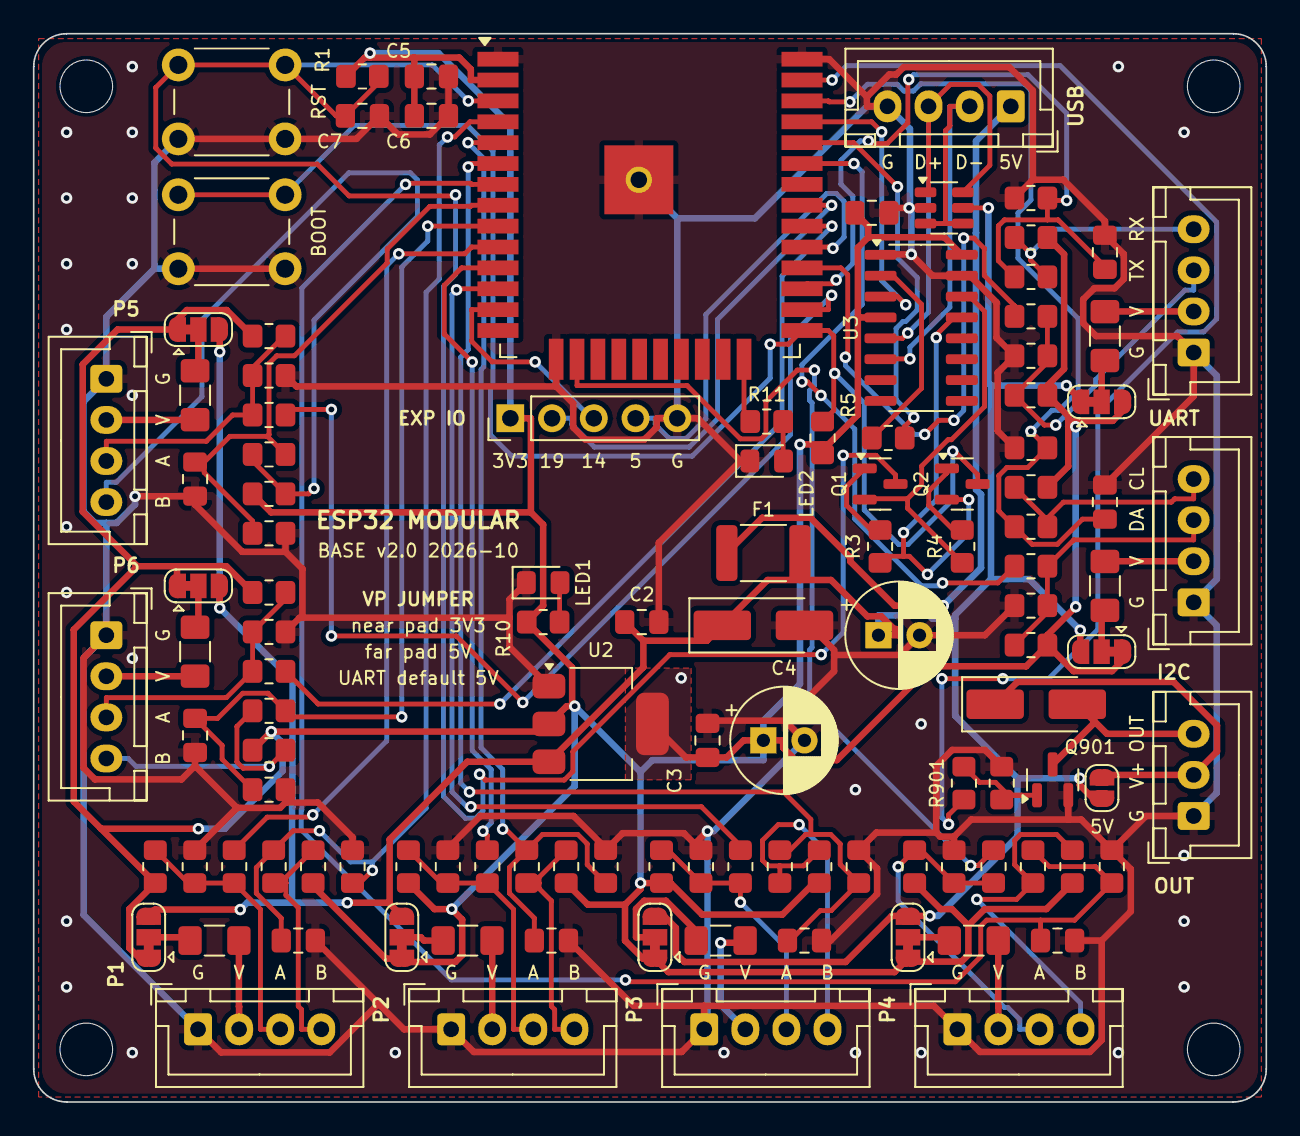
[picture p17: board esp32-modular.kicad_pcb from above]

Board: 2 copper layers, 75.0 x 65.0 mm, 119 parts (0 on the bottom side), 73 nets.
