stefangrozdanovski-sys/modular_esp32_board/(commit log)

2026-11-05 Add ESP32 Modular Base v2.0 hardware, docs and licences
    KiCad 7 project, generator scripts, BOM, assembly guide, iBOM, Gerbers.
    Hardware CERN-OHL-S-2.0, scripts MIT, docs CC BY-SA 4.0.
    Status: PCBs ordered, not yet built or tested.
    [esp32-modular-B_Cu.gbl, esp32-modular-B_Mask.gbs, esp32-modular-B_Paste.gbp, esp32-modular-B_Silkscreen.gbo, esp32-modular-Edge_Cuts.gm1, esp32-modular-F_Cu.gtl, esp32-modular-F_Mask.gts, esp32-modular-F_Paste.gtp]
2026-11-05 Add JLCPCB/PCBWay assembly files (production/pcba)
    - hardware/tools/pcba.py: BOM + CPL for JLCPCB and PCBWay from parts.py and
    the KiCad 7 position file, cross-checked against parts.py; JLCPCB rotation
    table; --verify mode for a live LCSC/JLCPCB lookup.
    - export.sh: KiCad 7 has no --exclude-dnp; use --smd-only and run pcba.py.
    - production/pcba: BOM, CPL, THT hand-solder list, README with ordering
    steps, LCSC verification table (only CH340C checked live) and the
    rotation caveat.
    - README, CHANGELOG updated.
    Claude-Session: https://claude.ai/code/session_01Mw2gjMfnyztQYL1MsaAQzZ
    [esp32-modular-v2.0-BOM-JLCPCB.csv, esp32-modular-v2.0-BOM-PCBWay.csv, esp32-modular-v2.0-THT-hand-solder.csv, positions.csv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]
2026-11-05 Add ESPHome firmware: base, port-job packages and examples
    - firmware/base.yaml: esp32dev 4 MB, ESP-IDF, Wi-Fi + fallback AP, API,
    OTA (encrypted with the API key), status LED GPIO2, BOOT button GPIO0,
    port pins as substitutions (resolve inside package vars).
    - 12 packages taking !include vars (id, name, pin + job values with
    defaults); all IDs derive from the id var. Pin limits documented in
    each file (no pulse_counter on GPIO36/39, B on P1-P4 input-only, ...).
    - Examples: test-board (assembly guide p.13), energy-relay, greenhouse.
    All pass `esphome config` on ESPHome 2026.10.2.
    - firmware/README.md, root README Firmware section, CHANGELOG.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
    [base.yaml]
2026-11-05 README: port overview, sensor list, PCBs received; generic VAT note in BOM app
2026-11-05 PCBA: record JLCPCB check of all 24 LCSC numbers (2026-11-05); fix 22uF MPN
    [esp32-modular-v2.0-BOM-PCBWay.csv]
2026-11-05 README: open items; firmware: flow sensor factor table
